Aylo6061/2040-pcb-assy-class/2040pad/2040pad.step

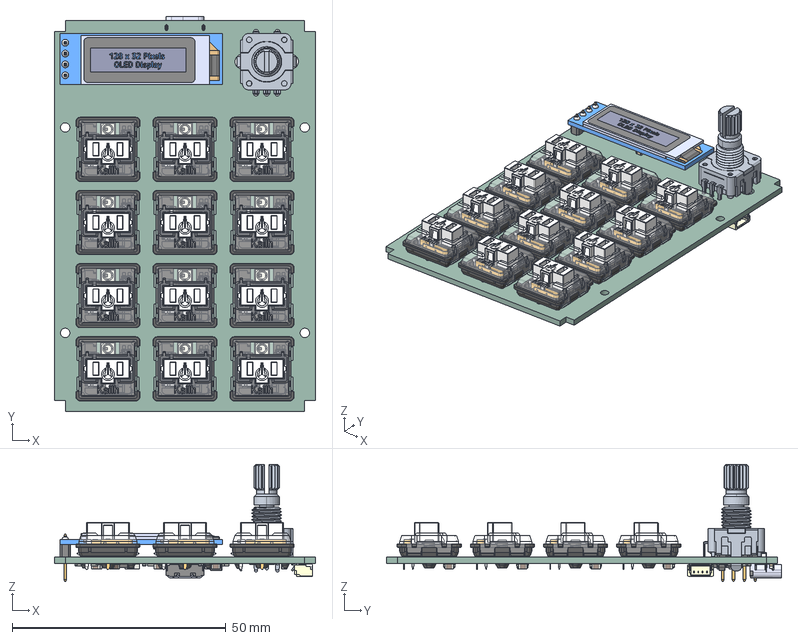
[picture p2: CAD file, 2026-11-06]
2040pad/2040pad.step
61.0 x 92.4 x 27.5 mm
PEC11R-4X15K-SXXXX
stem x 12
pin1 x 12
top x 12
shrunken_spring x 12
pin2 x 12
contact x 12
bottom x 12
click_bar x 12
Board_001
1x4 Male Header_001
0603 Capacitor_001
0603 Capacitor_002
0603 Capacitor_003
0603 Capacitor_004
0603 Capacitor_005
0603 Capacitor_006
0603 Capacitor_007
0603 Capacitor_008
0603 Resistor_001
0603 Resistor_002
0603 Resistor_003
0603 Resistor_004
0603 Resistor_005
Surface Mount Transistor_001
LED_SK6812MINI-E v2 x 12
C_0805_2012Metric x 22
LED_0603_1608Metric
R_0603_1608Metric x 13
SOT-23-5
SM04B-SRSS-TB(LF)(SN)
UJ20-C-H-G-SMT-1-P16-TR_UJ20-C-H-G-SMT-1-P16-TR
QFN-56-1EP_7x7mm_P0.4mm_EP3.2x3.2mm
2040pad_PCB
