Aylo6061/2040-pcb-assy-class/2040pad/2040pad.kicad_pcb

## KiCad design 2040pad/2040pad.kicad_pcb (2026-11-06)

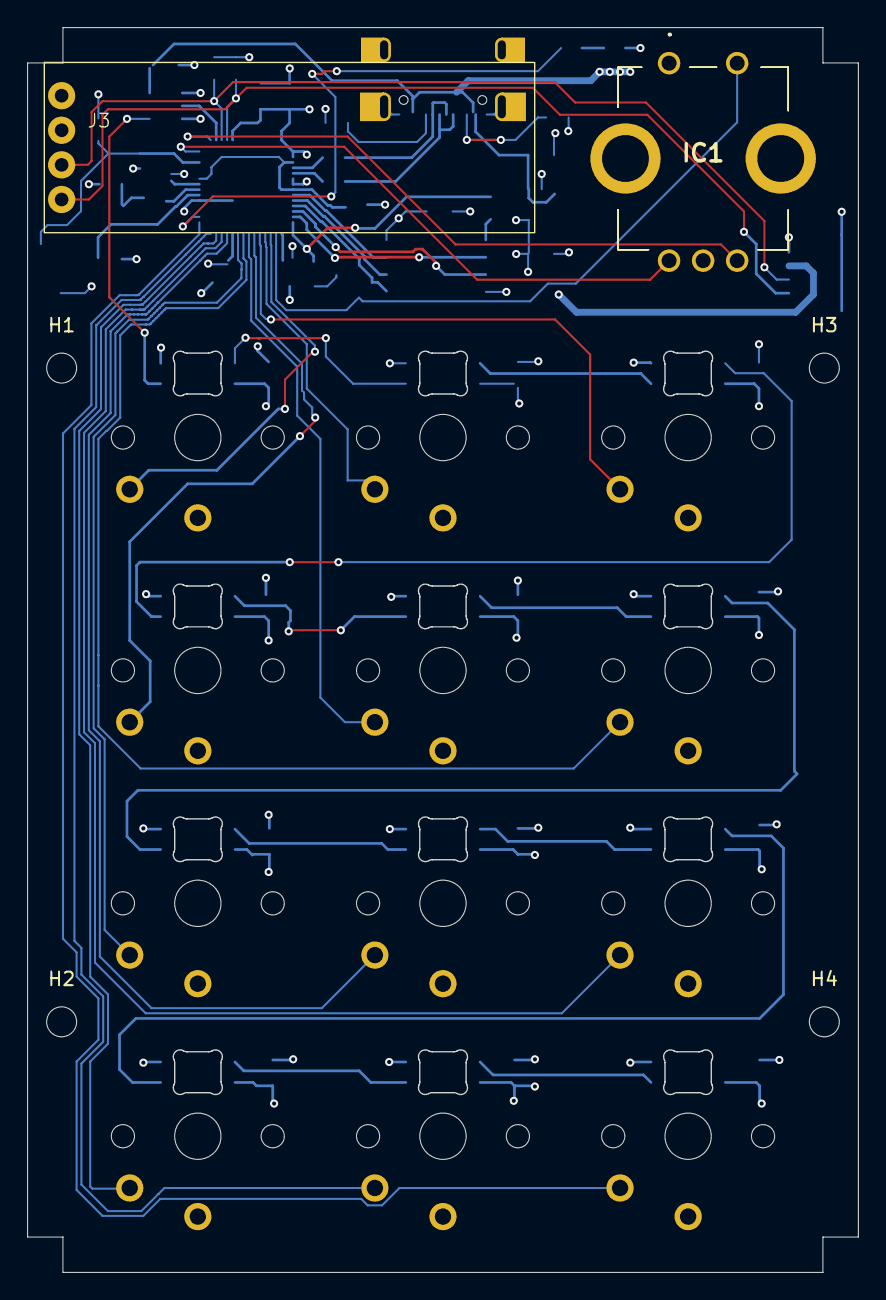
[picture p3: board 2040pad.kicad_pcb from above]

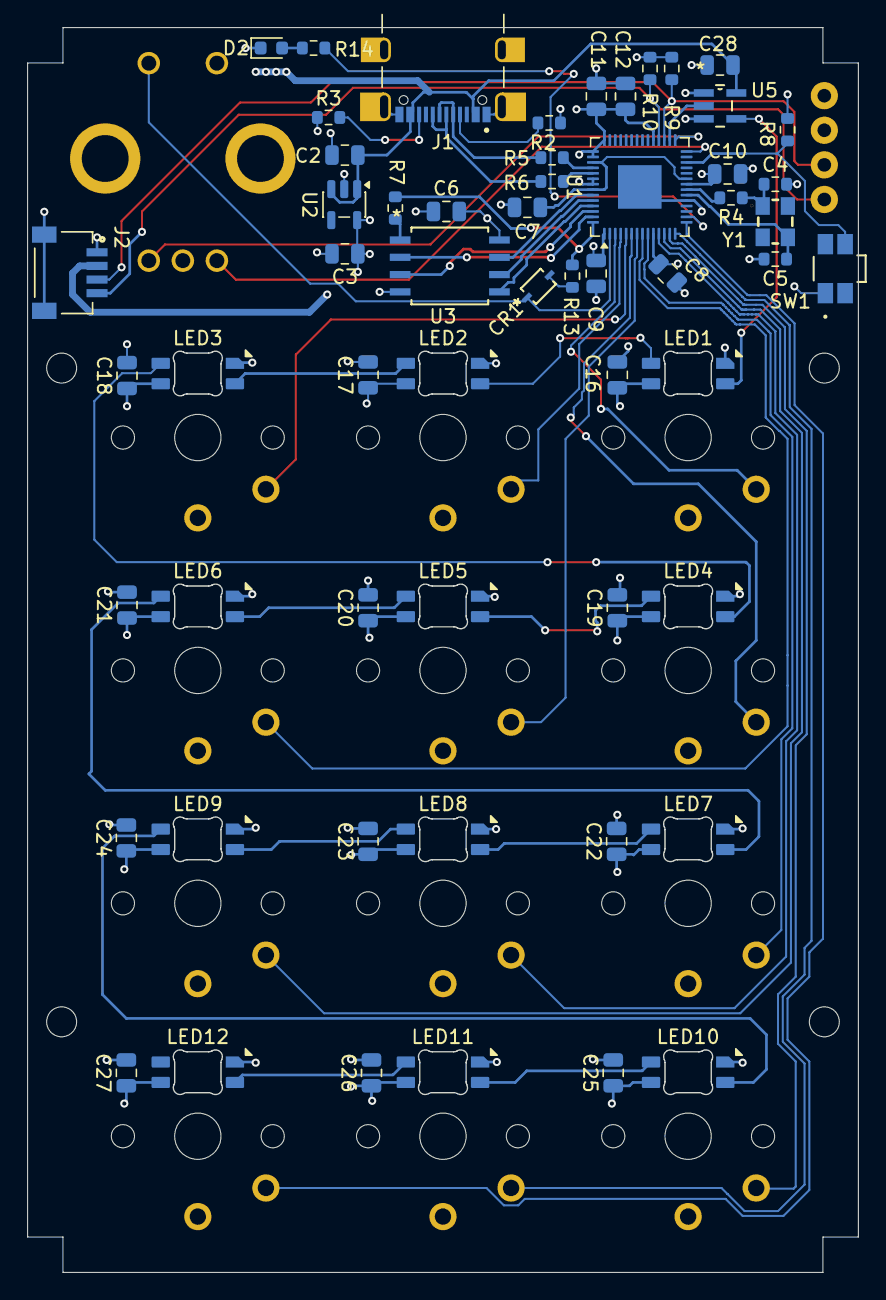
[picture p4: board 2040pad.kicad_pcb from below]

Board: 4 copper layers, 61.0 x 91.4 mm, 75 parts (57 on the bottom side), 54 nets.

Parts:
C2, C3: 10u; C_0805_2012Metric
C4, C5: 20p; R_0603_1608Metric
C6, C7, C8, C9, C10, C11, C12, C16, C17, C18, C19, C20, C21, C22, C23, C24, C25, C26, C27, C28: 1u; C_0805_2012Metric
CH1, CH2, CH3, CH4, CH5, CH6, CH7, CH8, CH9, CH10, CH11, CH12: choc_v1_SW_solder; SW_choc_v1_1u
CR1: 1N4148WS; SOD-323FL_ONS
D2: LED; LED_0603_1608Metric
H1, H2, H3, H4: MountingHole; MountingHole_2.2mm_M2
IC1: PEC11R-4230K-S0024; PEC11R4230KS0024
J1: UJ20-C-H-G-SMT-1-P16-TR; SAMESKY_UJ20-C-H-G-SMT-1-P16-TR
J2: SM04B-SRSS-TB_LF__SN_; JST_SM04B-SRSS-TB_LF__SN_
J3: Conn_01x04_Socket; Waveshare .91 oled
LED1, LED2, LED3, LED4, LED5, LED6, LED7, LED8, LED9, LED10, LED11, LED12: choc_SK6812MINI-E; LED_choc_6028R
R2, R3, R8, R9, R10, R14: 5k1; R_0603_1608Metric
R4, R13: 1k; R_0603_1608Metric
R5, R6: 22; R_0603_1608Metric
R7: 10k; R_0603_1608Metric
SW1: EVQ-P7J01P; SMD4_SW_EVQP7J_PAN
U1: RP2040; QFN-56-1EP_7x7mm_P0.4mm_EP3.2x3.2mm
U2: AP2112K-3.3; SOT-23-5
U3: W25Q64JVSSIM; SOIC_208MIL_WIN
U5: SN74AHCT1G125DBVR; DBV5
Y1: CX3225GB12000H0KPSC1; CX3225GB

Connections:
+1V2: C7.1, U1.23 (DVDD), U1.45 (VREG_VOUT), U1.50 (DVDD)
+3.3V: C3.1, C6.1, C8.1, C9.1, C10.1, C11.1, C12.1, J2.2, J3.1, R8.1, R9.1, R10.1, U1.1 (IOVDD), U1.10 (IOVDD), U1.22 (IOVDD), U1.33 (IOVDD), U1.42 (IOVDD), U1.43 (ADC_AVDD), U1.44 (VREG_VIN), U1.48 (USB_VDD), U1.49 (IOVDD), U2.5 (VOUT), U3.8 (VCC)
+5V: C2.1, C16.1, C17.1, C18.1, C19.1, C20.1, C21.1, C22.1, C23.1, C24.1, C25.1, C26.1, C27.1, C28.1, J1.A4_B9 (VBUS), J1.B4_A9 (VBUS__1), LED1.1 (VDD), LED2.1 (VDD), LED3.1 (VDD), LED4.1 (VDD), LED5.1 (VDD), LED6.1 (VDD), LED7.1 (VDD), LED8.1 (VDD), LED9.1 (VDD), LED10.1 (VDD), LED11.1 (VDD), LED12.1 (VDD), U2.1 (VIN), U2.3 (EN), U5.5 (VCC)
/SCL: J2.4, J3.4, R10.2, U1.32 (GPIO21)
/SDA: J2.3, J3.3, R9.2, U1.31 (GPIO20)
/keys+leds/Key1: CH1.1, U1.3 (GPIO1)
/keys+leds/Key2: CH2.1, U1.4 (GPIO2)
/keys+leds/Key3: CH3.1, U1.5 (GPIO3)
/keys+leds/Key4: CH4.1, U1.6 (GPIO4)
/keys+leds/Key5: CH5.1, U1.7 (GPIO5)
/keys+leds/Key6: CH6.1, U1.8 (GPIO6)
/keys+leds/Key7: CH7.1, U1.9 (GPIO7)
/keys+leds/Key8: CH8.1, U1.11 (GPIO8)
/keys+leds/Key9: CH9.1, U1.12 (GPIO9)
/keys+leds/Key10: CH10.1, U1.13 (GPIO10)
/keys+leds/Key11: CH11.1, U1.14 (GPIO11)
/keys+leds/Key12: CH12.1, U1.15 (GPIO12)
/keys+leds/Neopix_5v_in: LED1.3 (DIN), U5.4 (Y)
/keys+leds/Neopix_in: U1.30 (GPIO19), U5.2 (A)
/keys+leds/ROTA: IC1.A1 (A), U1.28 (GPIO17)
/keys+leds/ROTB: IC1.B1 (B), U1.29 (GPIO18)
/keys+leds/keyled1/led_out: LED2.2 (DOUT), LED3.3 (DIN)
/keys+leds/keyled2/led_out: LED3.2 (DOUT), LED4.3 (DIN)
/keys+leds/keyled3/led_out: LED4.2 (DOUT), LED5.3 (DIN)
/keys+leds/keyled4/led_out: LED5.2 (DOUT), LED6.3 (DIN)
/keys+leds/keyled5/led_out: LED6.2 (DOUT), LED7.3 (DIN)
/keys+leds/keyled6/led_out: LED7.2 (DOUT), LED8.3 (DIN)
/keys+leds/keyled7/led_out: LED8.2 (DOUT), LED9.3 (DIN)
/keys+leds/keyled8/led_out: LED9.2 (DOUT), LED10.3 (DIN)
/keys+leds/keyled10/led_in: LED10.2 (DOUT), LED11.3 (DIN)
/keys+leds/keyled10/led_out: LED11.2 (DOUT), LED12.3 (DIN)
/keys+leds/keyled/led_out: LED1.2 (DOUT), LED2.3 (DIN)
/micro+usb/D+: J1.A6 (DP1), J1.B6 (DP2), R6.1
/micro+usb/D-: J1.A7 (DN1), J1.B7 (DN2), R5.1
/micro+usb/QSPI_SCLK: U1.52 (QSPI_SCLK), U3.6 (CLK)
/micro+usb/QSPI_SD0: U1.53 (QSPI_SD0), U3.5 (DI(IO0))
/micro+usb/QSPI_SD1: U1.55 (QSPI_SD1), U3.2 (DO(IO1))
/micro+usb/QSPI_SD2: U1.54 (QSPI_SD2), U3.3 (nWP(IO2))
/micro+usb/QSPI_SD3: U1.51 (QSPI_SD3), U3.7 (nHOLD_nRESET)
/micro+usb/QSPI_SS: R7.1, R13.2, U1.56 (~QSPI_SS)
/micro+usb/USBBOOT: CR1.1, IC1.2 (NO), U1.2 (GPIO0)
/micro+usb/USERLED: R14.1, U1.16 (GPIO13)
/micro+usb/nRESET_2040: R8.2, SW1.3, U1.26 (RUN)
GND: C2.2, C3.2, C4.2, C5.2, C6.2, C7.2, C8.2, C9.2, C10.2, C11.2, C12.2, C16.2, C17.2, C18.2, C19.2, C20.2, C21.2, C22.2, C23.2, C24.2, C25.2, C26.2, C27.2, C28.2, CH1.2, CH2.2, CH3.2, CH4.2, CH5.2, CH6.2, CH7.2, CH8.2, CH9.2, CH10.2, CH11.2, CH12.2, D2.1 (K), IC1.1 (COM), IC1.C1 (C), IC1.MH1, IC1.MH2, J1.A1_B12 (GND), J1.B1_A12 (GND__1), J1.SH1 (SHIELD), J1.SH2 (SHIELD__1), J1.SH3 (SHIELD__2), J1.SH4 (SHIELD__3), J2.1, J2.S1 (SHIELD), J2.S2 (SHIELD__1), J3.2, LED1.4 (VSS), LED2.4 (VSS), LED3.4 (VSS), LED4.4 (VSS), LED5.4 (VSS), LED6.4 (VSS), LED7.4 (VSS), LED8.4 (VSS), LED9.4 (VSS), LED10.4 (VSS), LED11.4 (VSS), LED12.4 (VSS), R2.2, R3.2, SW1.1, U1.19 (TESTEN), U1.57 (GND), U2.2 (GND), U3.4 (GND), U5.1 (*OE), U5.3 (GND)
unnamed: C4.1, R4.1, Y1.1
unnamed: CR1.2, R13.1
unnamed: D2.2 (A), R14.2
unnamed: J1.A5 (CC1), R2.1
unnamed: J1.B5 (CC2), R3.1
unnamed: R5.2, U1.46 (USB_DM)
unnamed: R6.2, U1.47 (USB_DP)
unnamed: C5.1, U1.20 (XIN), Y1.3
unnamed: R4.2, U1.21 (XOUT)
unnamed: R7.2, U3.1 (nCS)
