Aylo6061/2040-pcb-assy-class/2040pad_assembly.html

LOADING BOARD…

Print / PDF

Zoom To Part Fit Board Flip

Notes

Pictures

## ALL PARTS PLACED

Start Over

Zoom animation

Display

Minimap Dim everything but the current part Outline parts already placed

Controls

→ / SpaceNext step ←Previous step RZoom back to the part FFit the whole board TFlip to the other side MShow or hide the minimap Scroll / pinchZoom DragPan Double-clickJump to the part under the cursor EscStop the animation, then fit

← Back Next →

← Back Print To make a PDF, choose "Save as PDF" as the printer. Print at 100% so the detail scales stay true.
