Aylo6061/2040-pcb-assy-class/docs/board-assembly.jpg

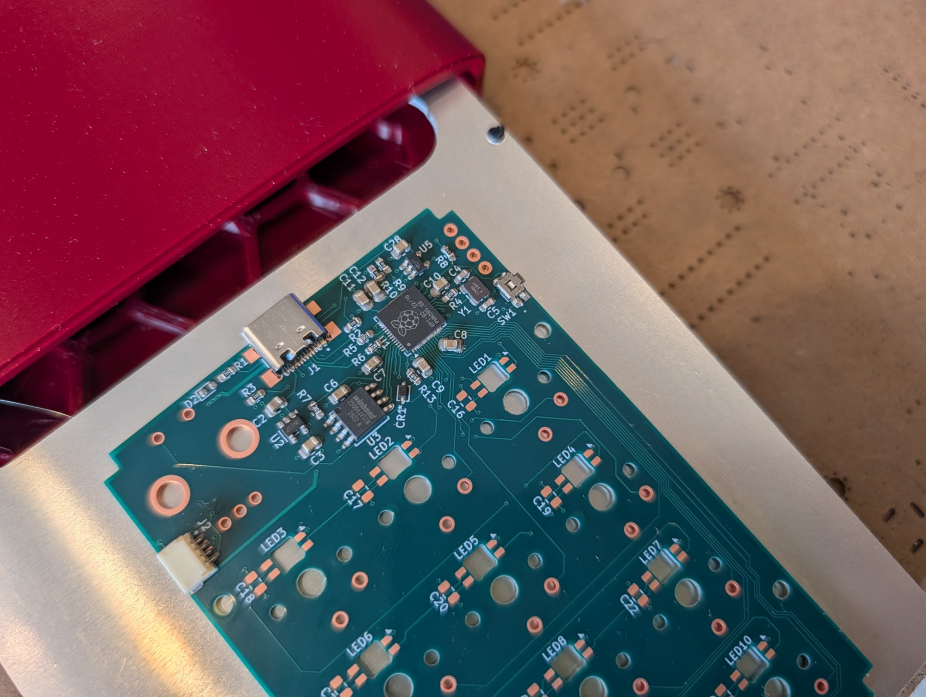
docs/board-assembly.jpg
