Aylo6061/2040-pcb-assy-class/(commit log)

2026-10-21 Add KiCad .gitignore
    Ignore KiCad temp/backup/local-history files, Eagle backups, and fab
    outputs (Gerbers, drill files, BOM/pick-and-place exports).
2026-10-21 Add 2040pad KiCad project
    Schematic (root + keys, micro, speaker sheets), PCB, and project-local
    footprint/symbol/3D model libraries.
    [2040pad.kicad_pcb, 2040pad.kicad_sch, keys.kicad_sch, micro.kicad_sch, speaker.kicad_sch]
2026-11-05 Add soldering class web page
    Static page for GitHub Pages, behind a simple secret code for now.
2026-11-06 Clean up repo and add 2040pad design files
    - Update the 2040pad KiCad board, schematics and libraries
    - Add 3D models, stencil data, footprints and gerbers
    - Add QMK firmware with GPL license text and copyright notices
    - Add the assembly guide in HTML and PDF
    - Remove the Adafruit board files, pinout and product image
    - Rewrite the README for 2040pad with Adafruit and QMK credits
    - Remove the secret code screen from the class page
    - Ignore mechanical/ and *.placewise
    [2040pad.kicad_pcb, 2040pad.kicad_sch, 2040pad.step, Adafruit MacroPad 2040 rev D.brd, Adafruit MacroPad 2040 rev D.sch, Adafruit MacroPad 2040.brd, Adafruit MacroPad 2040.sch, keyled.kicad_sch]
2026-11-06 Link design files on class page and fix copy
    - Replace the class page's coming soon list with firmware and board links
    - Fix a typo in the class size section
    - Update the firmware status now the encoder build is tested
